EileenYJH/ARIA/(commit log)

2026-05-06 ARIA v6: Hub + Node firmware, redesigned dashboard UI, README
    Hub: redesigned web dashboard (white-card UI, ARIA logo embedded,
    dark terminal log, clean zone/node cards matching reference design)
    Hub: charset UTF-8 fix (meta tag + content-type header)
    Hub: warden chat shows only user messages; system log in Technical tab
    Hub: unassigned node packets now default to Node 1 instead of dropped
    Node: firmware unchanged (v6 stable)
    README: full setup guide, technical breakdown, alert tiers,
    LED routing logic, serial commands, troubleshooting table
    [ARIA_Hub_v6.ino, ARIA_Node_v6.ino]
2026-05-06 Remove old root-level .ino files; updated versions are in subfolders
    ARIA_Hub_v6/ARIA_Hub_v6.ino and ARIA_Node_v6/ARIA_Node_v6.ino
    are the current v6 firmware with all recent changes applied.
2026-05-06 Fix: remove UTF-8 BOM from Hub .ino (caused undefined reference to setup/loop)
    PowerShell WriteAllText with Encoding.UTF8 added a 3-byte BOM that
    caused GCC to silently reject the file, making setup() and loop()
    invisible to the linker.
    [ARIA_Hub_v6.ino]
2026-05-06 Fix: restore all missing Hub functions (setup, loop, all logic)
    Previous rebuild script matched the forward declaration of htmlPage()
    instead of the function definition, cutting ~1150 lines of C++ logic.
    Reconstructed from git history with all targeted fixes re-applied:
    - charset content-type fix (setupDashboard, 2 occurrences)
    - unassigned node defaults to Node 1 (onDataRecv)
    - new dashboard UI (htmlPage, unchanged)
    No UTF-8 BOM.
    [ARIA_Hub_v6.ino]
2026-05-06 Fix: remove duplicate int tier and pendingNodeMap declarations
    Merge from git history introduced two duplicates:
    - int tier declared twice in updateAlertNotifications()
    - uint8_t pendingNodeMap defined at both line 163 and 1138
    [ARIA_Hub_v6.ino]
2026-05-06 Hub: replace IR sensor with 3 LDR laser-break sensors (GPIO 34/35/32); redesign floor map to match physical layout; node: replace ventilation LED with DC fan relay on GPIO 18
    Hub changes:
    - Remove single IR sensor + SETIR assignment system
    - Add dedicated LDR laser-break sensors per exit (A=GPIO34, B=GPIO35, C=GPIO32)
    - New congestion algorithm: count persons per 30-s window, congested >23 (≈46/min)
    - Obstruction emergency when beam blocked >8 s
    - Redesign live floor map: 4 top rooms (N1-N4), horizontal corridor with Exit A/C on sides, vertical corridor to Exit B, N5/N6 flanking vertical section
    - Particle paths updated to match new layout (ZoneA→left, ZoneB→down, ZoneC→right)
    Node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
    [ARIA_Hub_v6.ino, ARIA_Node_v6.ino]
2026-05-06 Fix: node assignment now immediate — SETNODE broadcasts wirelessly and clears pendingNodeMap after use
    Previously SETNODE X (web UI) only set a hub-side pending flag waiting for a
    nodeID=0 packet, so data never appeared if the node was already sending with
    any ID, and pendingNodeMap was never cleared causing future unassigned nodes to
    collide silently into the same slot.
    Fix:
    - SETNODE X also broadcasts sendNodeCommand(0, SETNODE X) so physical unassigned
    nodes adopt the new ID within one packet interval (~500 ms)
    - pendingNodeMap cleared to 0 after first successful remap so subsequent
    unassigned nodes are not silently redirected to the same slot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
    [ARIA_Hub_v6.ino]
2026-05-06 Fix: LDR congestion now triggers immediately when threshold crossed, not just at 30-s boundary
    Three bugs fixed in updateLdrExit():
    1. Congestion was only evaluated at the end of the 30-s window. If 24 people
    passed in the first 10 s, nothing showed until second 30. Now triggers the
    moment personCount crosses LDR_CONGESTION_COUNT (23); the 30-s boundary is
    used to CLEAR congestion when the rate has dropped.
    2. Congestion status change did not call needsImmediatePush, so the dashboard
    waited up to 1 s for the next WS tick. All state changes now set
    needsImmediatePush = true.
    3. No minimum blockage debounce — a 1 µs noise spike on the LDR counted as a
    person. Added 50 ms m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
    [ARIA_Hub_v6.ino]
2026-05-06 LED strip: single LED packet that grows to 2-3 as it approaches exit
    Replaces the dimming-trail approach with a clean packet effect:
    - Far from exit: 1 solid LED
    - Within 4 pixels of exit: 2 solid LEDs
    - Within 2 pixels of exit: 3 solid LEDs
    All pixels in the packet are full brightness (no dimming), giving a
    compact block that visually bunches up as it nears the exit.
    [ARIA_Hub_v6.ino]
2026-05-07 fix(hub): rewrite canvas drawParticles to 1→2→3 packet behavior
    Replace spread-N-particles logic with a single compact packet that grows
    from 1 dot (far from exit) to 2 (within 40% remaining path) to 3 (within
    20%), matching the physical WS2812B LED strip behavior. Remove the unused
    count parameter from all 12 call sites.
    [ARIA_Hub_v6.ino]
2026-05-07 fix(hub): remove Zone B split — unified DIR_LEFT/DIR_RIGHT per exit state
    Zone B LEDs 10-19 now move as a single packet:
    - DIR_RIGHT (LED 10→19): heading to Exit B (primary exit)
    - DIR_LEFT (LED 19→10): back to horizontal corridor when Exit B is
    blocked or dangerous, joining Exit A or C guidance
    Remove DIR_SPLIT, DIR_CONVERGE, drawSplitZoneB(), drawConvergeZoneB().
    Re-derive render direction for every fire/gas combination so Zone B
    always uses a single whole-zone chase, consistent with zones A and C.
    [ARIA_Hub_v6.ino]
2026-05-07 feat(node+hub): add MQ-135 air quality sensor and integrate into scoring
    Node (GPIO 35):
    - Calibrate MQ-135 alongside MQ-2/MQ-7; derive SlightPoor/Poor/Hazard thresholds
    - EMA smoothing (α=0.3) in readSensors(); field added to SensorData and NodePacket
    - calculateFireScore: +1 both MQ-2+MQ-135 elevated (cross-confirm smoke),
    +1 MQ-135 hazard + flame (well-developed fire); −1 MQ-135 high but no smoke/flame
    (chemical gas, not fire); dust/steam penalty now also requires clean MQ-135
    - updateGasLeak: MQ-135 hazard alone (without MQ-2 spike) triggers gas-leak mode
    for chemical gases (NH3, benzene, alcohol) the MQ-2 cannot detect
    - updateFan: airQualRun trigger — fan turns on when MQ-13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
    [ARIA_Hub_v6.ino, ARIA_Node_v6.ino]
2026-05-07 fix(node): scoring and fan relay bugs
    Scoring:
    - flameConfirmed now adds +5 (was +3) so flame alone guarantees SCORE_FIRE
    without needing CO or humidity to cooperate
    - All negative score corrections are now gated by !flameConfirmed — the
    'MQ-2 spike but no CO' penalty was wrongly subtracting 2 even when a
    flame was physically detected, keeping the score at 2-4 instead of >=5
    - MQ-2 spike value increased to +2 (was +1); CO fast-rise threshold
    relaxed to >5 ppm/sample (was >10) for more realistic MQ-7 response
    - gasLeakMode no longer suppresses fireScore — it is a separate actuator
    flag; both fire detection and gas detection run in parallel so a flame
    during gas mode is not sil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
    [ARIA_Node_v6.ino]
2026-05-10 feat(hub): add second LED strip on GPIO 4 with Zone A (22) + Zone C (18), no Zone B
2026-05-10 fix(hub): serve HTML from PROGMEM to prevent heap exhaustion with multiple clients
    - Move htmlPage() to static PROGMEM constant, served via send_P() in chunks
    (eliminates ~15-20 KB heap spike per device page load)
    - Raise soft AP max_connection 4 → 8
    - Pass explicit limit of 8 to ws.cleanupClients() instead of library default
    [ARIA_Hub_v6.ino]
2026-05-10 fix(hub+node): apply code review quick wins
    Node:
    - Fix PIN_FAN comment: GPIO 18 → GPIO 19
    - Fix CO_PPM_DANGEROUS: 35 → 50 (was same as CONCERN, dead threshold)
    - Seed mq2Ema/mq135Ema from real ADC reads in setup() (no more cold-start false spikes)
    Hub:
    - Remove empty updateOutputs() stub
    - Fix JS node badge: CONNECTED/ONLINE → LIVE/OFFLINE
    - Add WiFi STA auto-reconnect every 30s (keeps Telegram alive after drop)
    - Add CLEAR OBSTRUCTION A/B/C serial/web command
    - Whitelist CLEAR OBSTRUCTION from chat log
    [ARIA_Hub_v6.ino, ARIA_Node_v6.ino]
2026-05-10 fix(node): tiered CO scoring — use all four CO thresholds
    Replace flat concern-only CO logic with four-tier escalation
    (CONCERN+1, DANGEROUS+2, FIRE+3, CRITICAL+4) plus a +1 fast-rise
    bonus. Narrow slow-CO false-positive penalty to concern level only
    so genuinely dangerous CO is never penalised.
    [ARIA_Node_v6.ino]
2026-05-10 fix(hub): Zone B live map particles now start from N2/N3 corridor positions
    pB single path started at the junction (midX) so Zone B particles only
    appeared in the vertical section. Split into pB_N2 and pB_N3 so each
    node flows from its own corridor column centre to the junction, then
    down to Exit B — matching the same horizontal corridor coverage that
    Zone A (N1→ExitA) and Zone C (N4→ExitC) show.
    [ARIA_Hub_v6.ino]
2026-05-10 fix(hub): forward-declare HTML_PAGE before setup() to fix compile error
    HTML_PAGE PROGMEM string is defined at line ~1353 but setup() lambdas
    reference it at lines 441/450. C++ requires declaration before use;
    added extern forward declaration in the existing forward-decl block so
    the compiler knows the symbol exists before it compiles setup().
    Cascading 'function does not name a type' errors were caused by the
    compiler misinterpreting the raw-string PROGMEM block after the initial
    undeclared-symbol failure.
    [ARIA_Hub_v6.ino]
2026-05-10 fix(hub): resolve extern/static linkage conflict on HTML_PAGE
    extern forward-declaration and static definition are contradictory;
    the compiler rejected the mismatch and failed to parse the raw-string
    literal that follows, producing all the cascading 'function does not
    name a type' errors. Remove 'static' so both declarations use external
    linkage.
    [ARIA_Hub_v6.ino]
2026-05-10 fix(hub): move HTML PROGMEM string to html_page.h to fix raw-literal compile error
    The Arduino IDE preprocessor does not understand C++11 raw string
    literals. It treated R"rawliteral( as identifier R + short string
    "rawliteral(" and then parsed the entire HTML/JS body as C++, producing
    the 'function does not name a type' errors for every JS function.
    Fix: extract the PROGMEM declaration into a standalone header file
    (html_page.h). The Arduino preprocessor only touches .ino files; .h
    files are passed straight to the compiler which handles raw strings
    correctly. Removed the extern forward-declaration that is no longer
    needed.
    [ARIA_Hub_v6.ino]
2026-05-10 feat(hub): remap strip 2 to 17+9+13 with Zone B static and 3→5 packet chase
    Strip 2 layout: Zone A LEDs 0-16 | Zone B LEDs 17-25 | Zone C LEDs 26-38
    Total 39 LEDs (was 40, no Zone B gap).
    Zone A & C on strip 2: chase animation using new drawChaseRangeBuf2 —
    base packet 3 LEDs, grows to 4 within 5 LEDs of exit, 5 within 2 LEDs.
    Zone B on strip 2: solid static colour matching zone status —
    red = fire/danger, yellow = warning/gas, green = safe exit.
    No chasing on Zone B segment.
2026-05-10 fix(hub): explicit strip clears + Zone B strip2 breathing pulse
    Replace FastLED.clear() with explicit fill_solid per strip — guarantees
    leds2 is zeroed every frame regardless of FastLED multi-strip quirks,
    preventing stale-colour bleed and wrong-colour residuals.
    Zone B strip 2 indicator now breathes at 18 BPM instead of being a hard
    static fill, making it visually distinct from the adjacent Zone A/C
    chase packets so it cannot be mistaken for a stray chase LED.
    [ARIA_Hub_v6.ino]
2026-05-10 fix(hub): Zone B strip2 warning colour yellow → orange
    [ARIA_Hub_v6.ino]
2026-05-10 feat(hub): Zone B strip2 gas leak → white indicator
    [ARIA_Hub_v6.ino]
2026-05-10 feat(hub): gas-only mode → both strips solid white static
2026-05-12 feat(hub): SOS buzzer Morse ... --- ... + hub reliability improvements
    - Replace flat SOS beep with full Morse SOS state machine (... --- ...)
    matching node behaviour; step resets when SOS goes inactive
    - Channel 11 → 6; re-lock comment and STA reconnect guard updated
    - Strip 2 layout: Zone B 9→8 LEDs, Zone C 13→15 LEDs (NUM_LEDS2 39→40)
    - FASTLED_ALLOW_INTERRUPTS 0 + INTERRUPT_RETRY_COUNT 1 to protect WS2812B
    - FastLED colour correction + setMaxRefreshRate(120)
    - renderLedRouting: EVERY_N_MILLISECONDS macro + skip FastLED.show() when
    pixels unchanged (reduces ISR blocking)
    - ldrRaw[] array + runtime-tunable ldrThreshold (LDRTHRESH command)
    - espnowPktRx[] heartbeat counter;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
    [ARIA_Hub_v6.ino, ARIA_Node_v6.ino]
2026-05-12 feat(node): disable WiFi power save for reliable ESP-NOW reception refactor(hub): reduce heap allocation and fragmentation
    - Add esp_wifi_set_ps(WIFI_PS_NONE) in setupEspNow() so hub→node
    commands (SOS ON, SETNODE, FIRE ON) are never dropped due to
    the radio sleeping between TX cycles
    - logLines[8] and chatLines[12]: String[] → char[][] fixed arrays,
    eliminating 20 heap-allocated String objects and their fragmentation
    - dashboardJson(): static String with reserve(1500) — buffer allocated
    once at first call, reset to "" each push; return const String& to
    avoid copy at every WebSocket push (was: alloc+free 1400 B/second)
    - Log/chat JSON serialisation: replace tempor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
    [ARIA_Hub_v6.ino, ARIA_Node_v6.ino]
2026-05-14 fix: SCORE_FIRE 5→6 on hub+node; update README to match v6 firmware
    - Raise SCORE_FIRE from 5 to 6 (hub + node) to align thresholds
    - Fix hub log message: ch11 → ch6 (correct ESP-NOW/STA channel)
    - Refine gas-only LED condition: solid white only when score < SCORE_AMBER,
    yellow chase when score is in warning range (gas + pre-warning can co-exist)
    - README fully rewritten to match v6 firmware:
    · Channel 6 everywhere (was 11)
    · Hub hardware: two LED strips (30px + 40px) + 3× LDR laser sensors
    · Hub pin table: add GPIO 17 (Strip 2), GPIO 35/32 (LDR B/C)
    · Node pin table: fix relay GPIO 12→19, add GPIO 35 (MQ-135)
    · Remove SETIR command; add LDRTHRESH + CLEAR OBSTRUCTION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
    [ARIA_Hub_v6.ino, ARIA_Node_v6.ino]
